shadmehr1/Desk-Cleaning-Robot/Hand-Gelina Jolie BOM.xlsx

Part Name | Ordered | Count | Cost | Source | Alternate Source | Notes
SG90 Servos | FALSE | 3 | $6.99 | https://www.amazon.com/WWZMDiB-SG90-Control-Servos-Arduino/dp/B0BKPL2Y21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
MG995 Servos | FALSE | 3 | $16.99 | https://www.amazon.com/Control-Angle180-Digital-Torque-Helicopter/dp/B07NQJ1VZ2?cv_ct_cx=MG995%2FMG996R+Servo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
Arduino Uno | FALSE | 1 | $14.99 | Amazon.com: ELEGOO UNO R3 Board ATmega328P with USB Cable(Arduino-Compatible) for Arduino : Electronics (https://www.amazon.com/dp/B01EWOE0UU?ref_=ppx_hzsearch_conn_dt_b_fed_asin_title_1) | https://www.amazon.com/ELEGOO-Project-Tutorial-Controller-Projects/dp/B01D8KOZF4?s=toys-and-games
5V 3A Power Supply Adapter | FALSE | 1 | $10.99 | Amazon.com : MTYTOT 5V 3A DC Power Supply Adapter, AC 100V240V to DC 5V, 3A Max, 15W, 5.5x2.5mm Plug, for LED Lights, CCTV, Routers, Security Systems : Electronics (https://www.amazon.com/dp/B0BV64MHY6?ref=ppx_yo2ov_dt_b_fed_asin_title)
2.1mm DC Jack Female | FALSE | 1 | $7.99 | Amazon.com: Eightnoo 5Pcs 5.5 x 2.1 mm DC Power Jack Socket, Real 18AWG 20cm DC Power Cord Barrel Connectors Threaded Female Panel Mount Sockets Adapter with Dust Caps for CCTV Security Camera : Electronics (https://www.amazon.com/Eightnoo-Connectors-Threaded-Sockets-Security/dp/B0DLKN8J7M?s=industrial)
3D Printed Solid Parts (PLA) | FALSE |  | $7.91 | https://cults3d.com/en/3d-model/gadget/brazo-robotico-con-arduino-step-files-robotic-arm-guardar-reproducir-export
Dupont Wire Jumper Cables | FALSE |  | $5.98 | Amazon.com: ELEGOO 120pcs Multicolored Dupont Wire 40pin Male to Female, 40pin Male to Male, 40pin Female to Female Breadboard Jumper Ribbon Cables Kit Compatible with Arduino Projects : Electronics (https://www.amazon.com/dp/B01EV70C78?ref=ppx_yo2ov_dt_b_fed_asin_title)
Lever Wire Connectors | FALSE | 1 | $10.99 | HTCELLE Lever Wire Connectors, 75 Pcs Wire Connector Assortment Pack Compact Splicing Connector Kit for Electrical Wires Solid Stranded Flexible Wires, 2 Port, 3 Port, 5 Port: Amazon.com: Industrial & Scientific (https://www.amazon.com/Connector-Assortment-Splicing-Electrical-Stranded/dp/B07NPGV7G2)
Hardware Kit (M3) | FALSE | 1 | $7.99 | 420pcs M3 Screw Kit, Premium M3 Bolts for 3D Printing, Hex Socket Head Cap Screw Assortment with Nuts and Washers, M3 x 6mm /8mm /10mm /12mm /16mm /20mm /25mm (Black): Amazon.com: Industrial & Scientific (https://www.amazon.com/420pcs-Premium-Printing-Assortment-Washers/dp/B0CSX4NX7R?s=industrial)
Subtotal |  |  | $90.82
Tax |  |  | $8.63
Total |  |  | $99.45
